cepr/vw-bus-project-ecu/hardware/tps.jpg

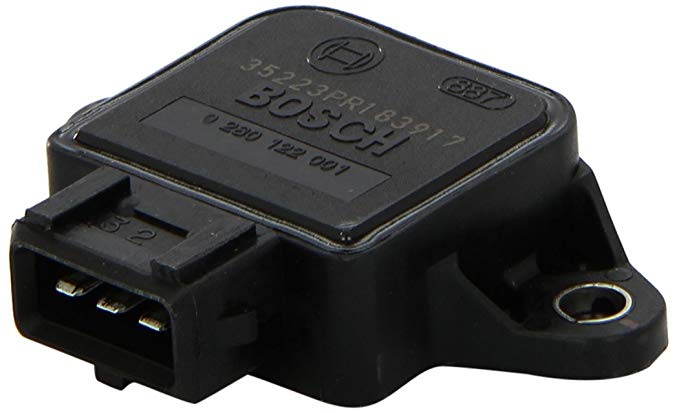
hardware/tps.jpg
