cepr/vw-bus-project-ecu/hardware/crankshaft_pos_sensor.jpg

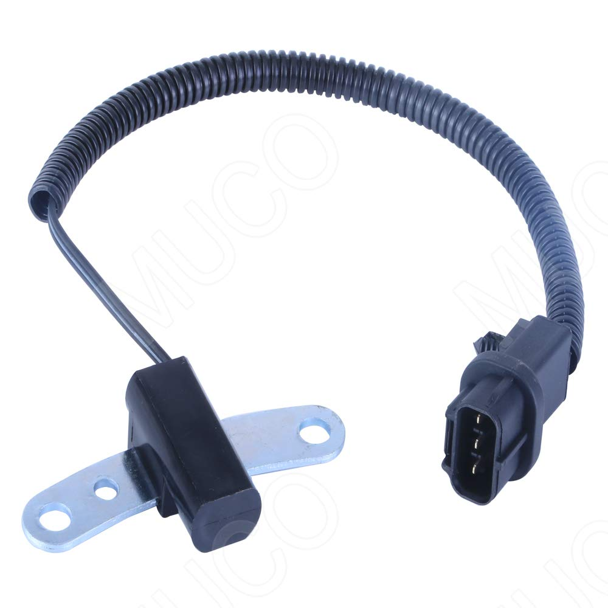
hardware/crankshaft_pos_sensor.jpg
