cepr/vw-bus-project-ecu/README.md

# vw-bus-project-ecu
ECU based on Speeduino for my VW Bus project

# Licenses
The schematics and layout are under the TAPR Open Hardware License v1.0
