cepr/vw-bus-project-ecu/hardware/ignitor.jpg

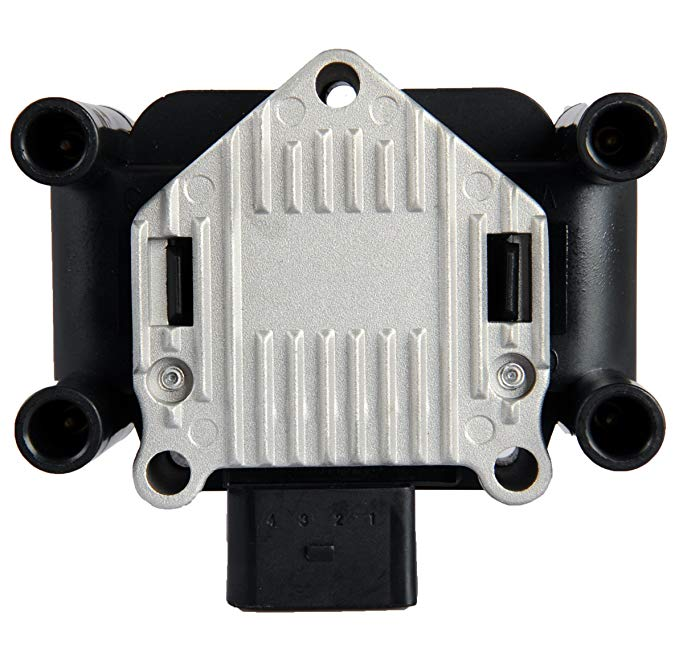
hardware/ignitor.jpg
