cepr/vw-bus-project-ecu/hardware/pdf/speeduino_mini.pdf

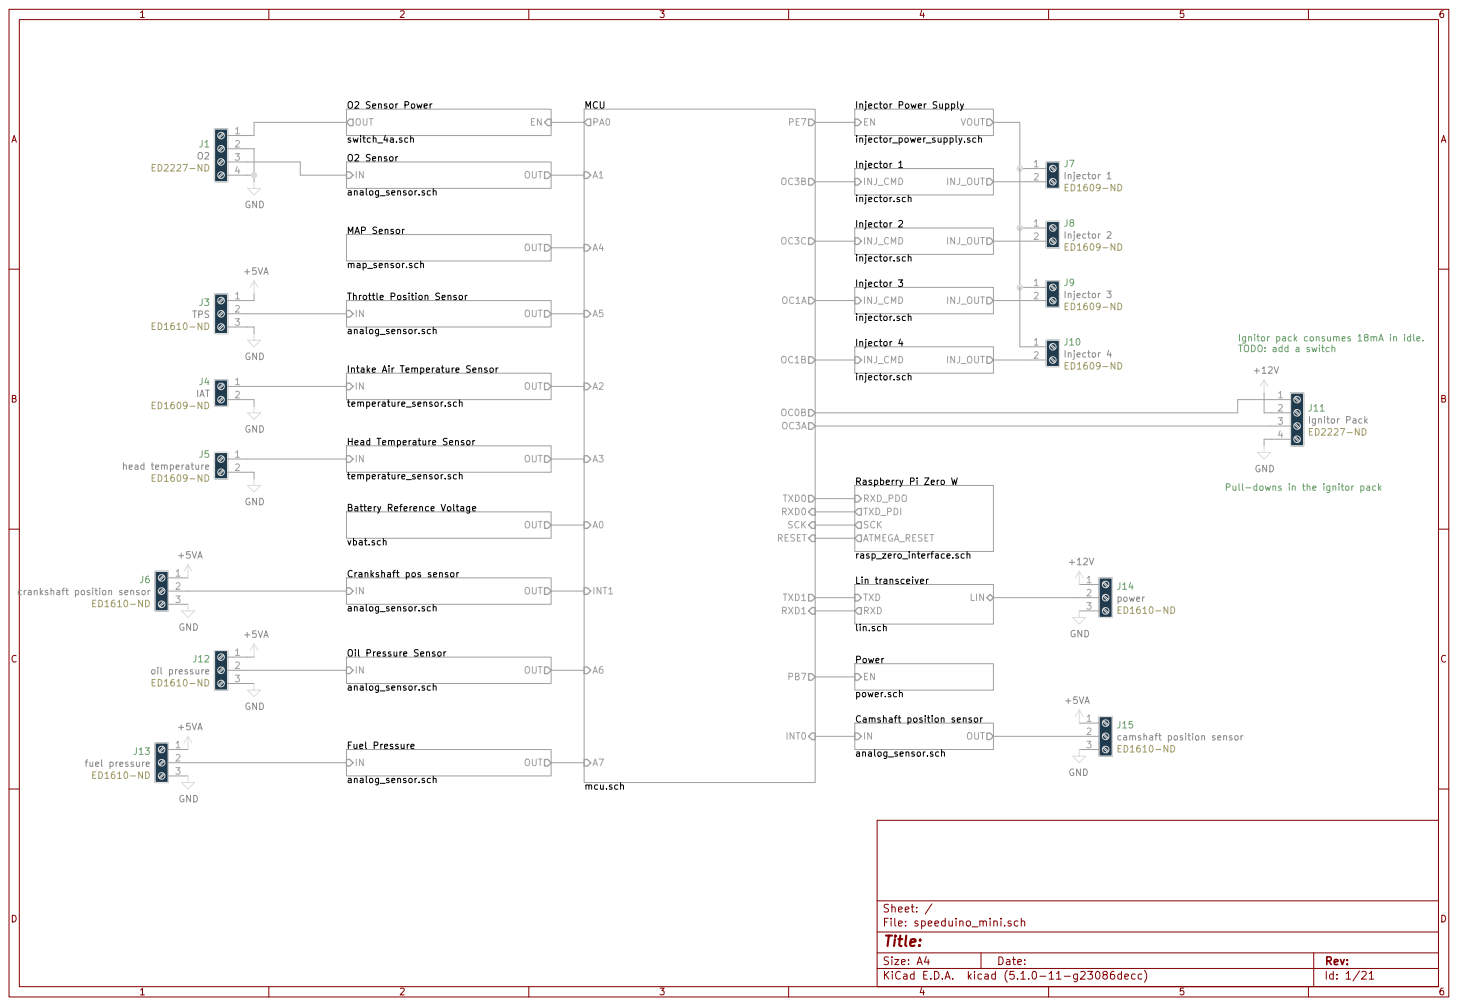
[picture p4: page 1]

Injector 3
injector.sch
Ignitor pack consumes 18mA in idle. TODO: add a switch Camshaft position sensor
Injector 4

Throttle Position Sensor analog_sensor.sch

Injector 4 ED1609-ND Oil Pressure Sensor analog_sensor.sch
Intake Air Temperature Sensor
temperature_sensor.sch

Pull-downs in the ignitor pack

crankshaft position sensor ED1610-ND

Power power.sch EN

camshaft position sensor ED1610-ND

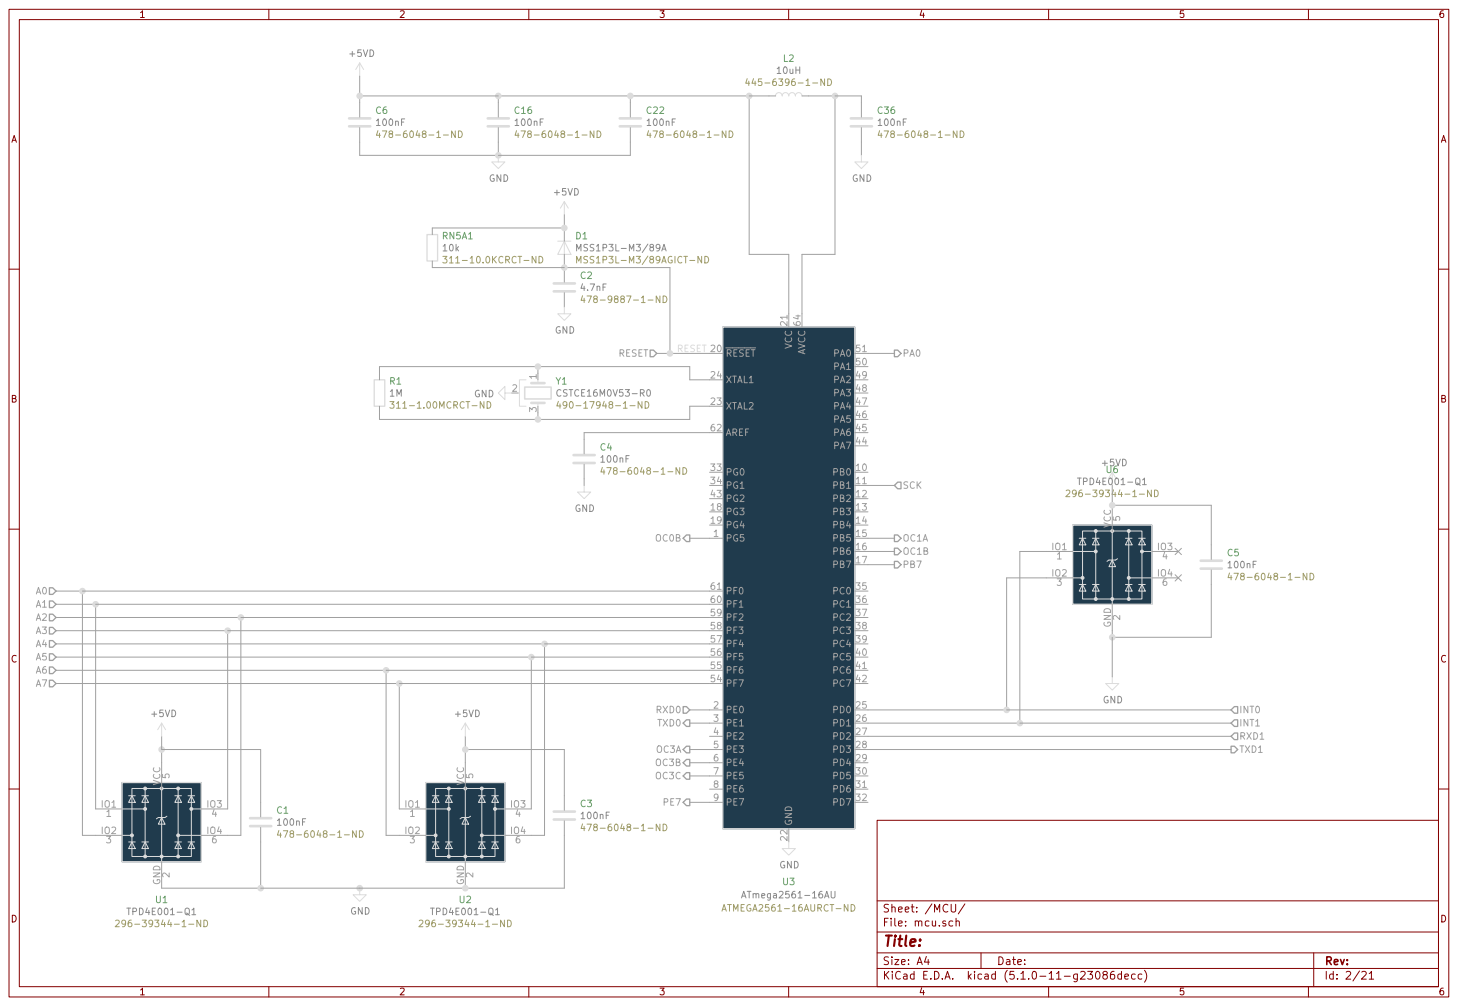
[picture p5: page 2]

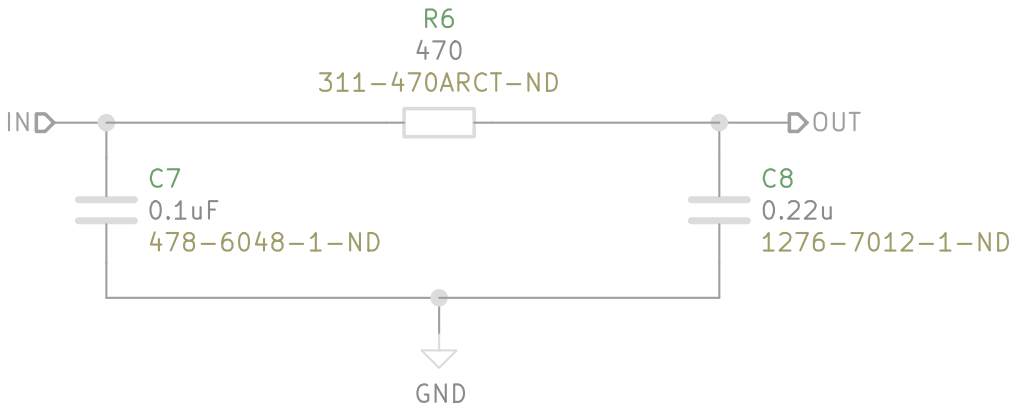
[picture p6: page 3]

File: analog_sensor.sch Sheet: /O2 Sensor/
Id: 3/21 Title:

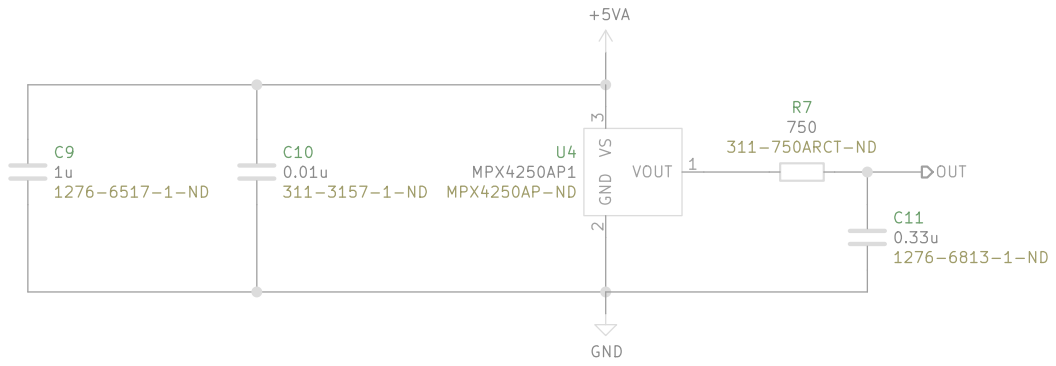
[picture p7: page 4]

File: map_sensor.sch Sheet: /MAP Sensor/
Id: 4/21 Title:

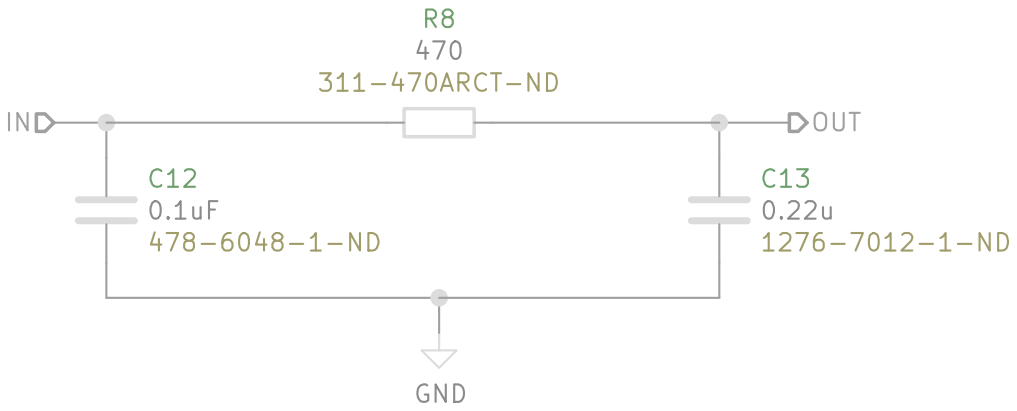
[picture p8: page 5]

File: analog_sensor.sch Sheet: /Throttle Position Sensor /
Id: 5/21 Title:

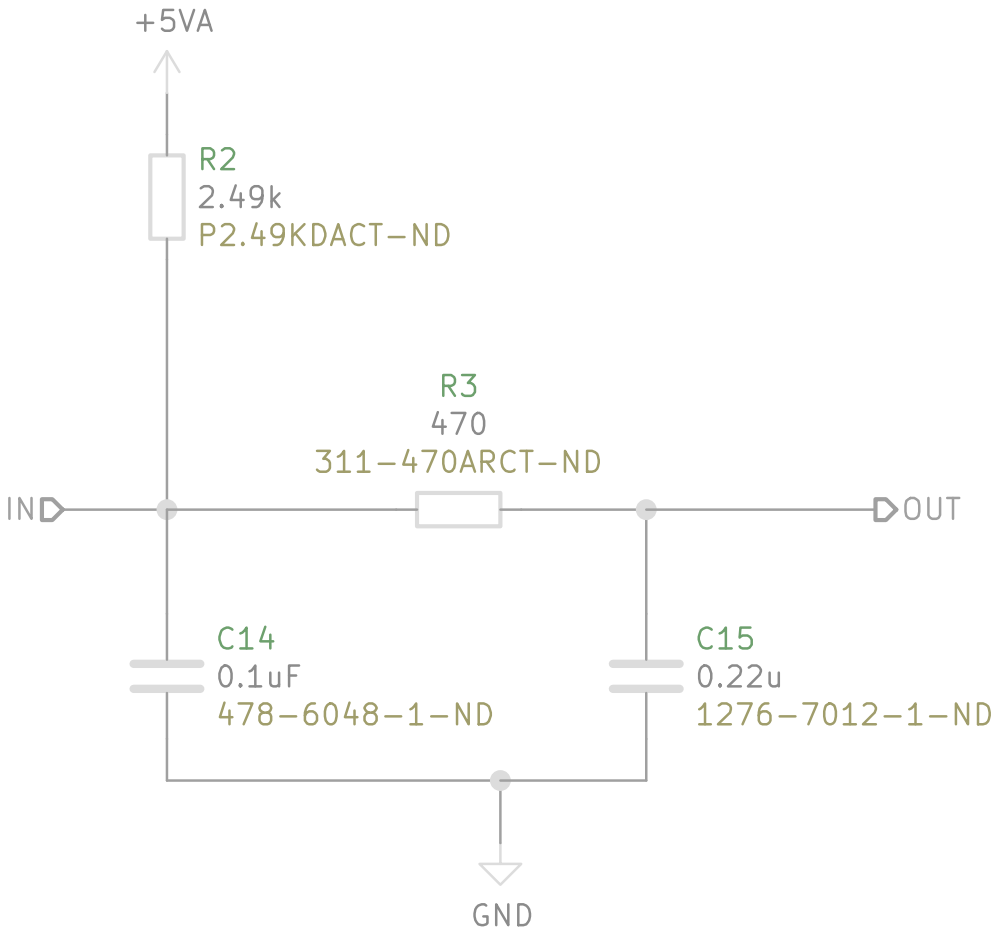
[picture p9: page 6]

Sheet: /Intake Air Temperature Sensor/
File: temperature_sensor.sch
Id: 6/21 Title:

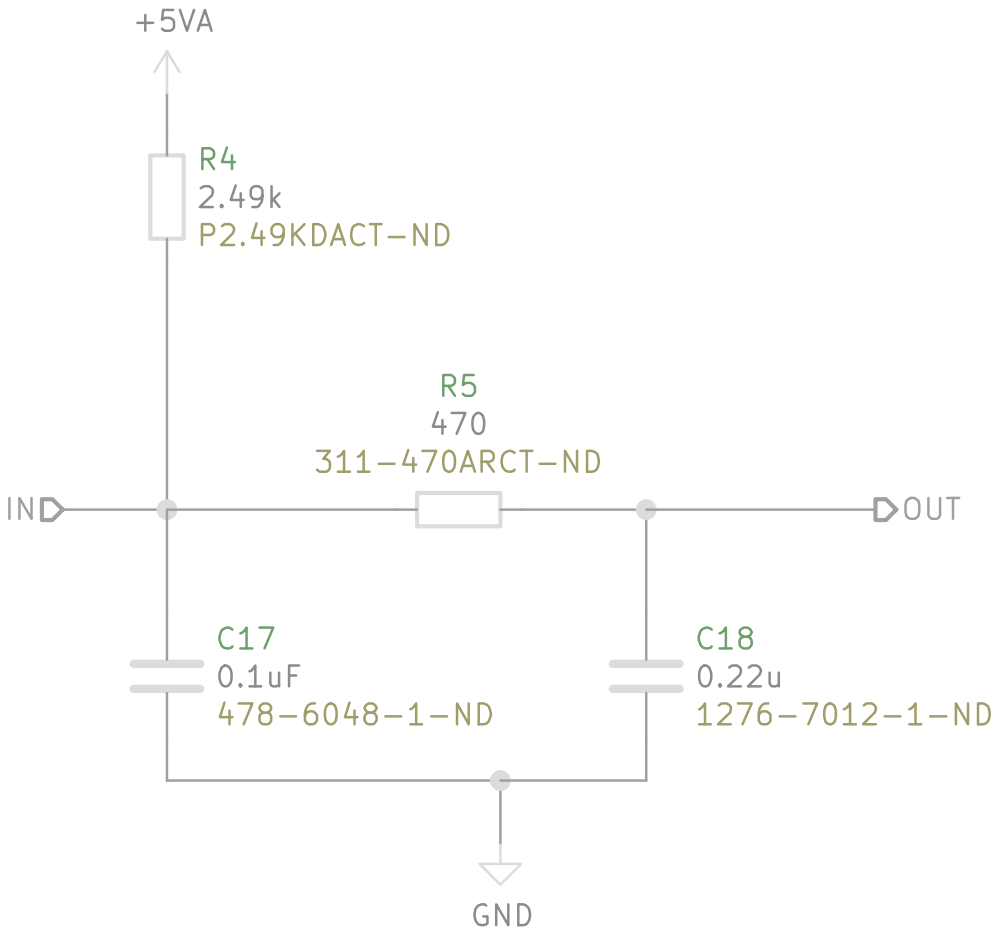
[picture p10: page 7]

Sheet: /Head Temperature Sensor/
File: temperature_sensor.sch
Id: 7/21 Title:

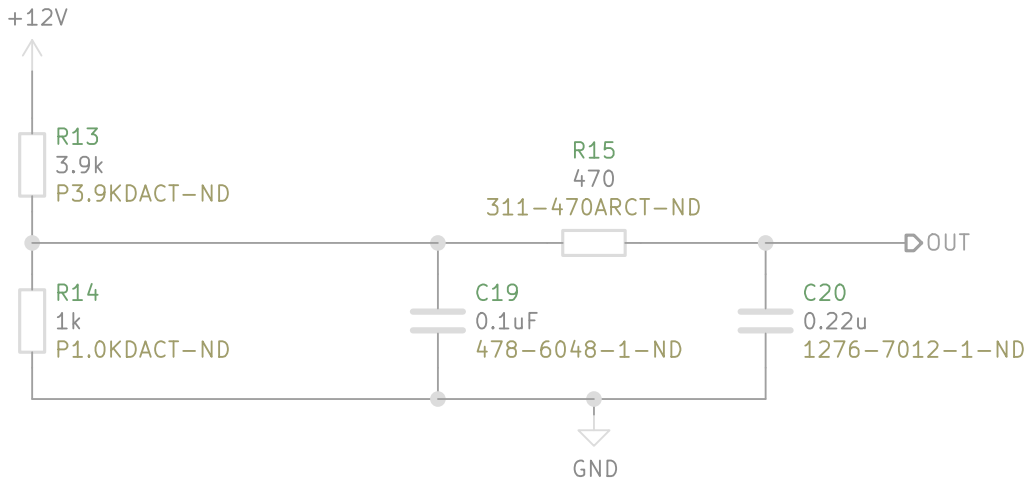
[picture p11: page 8]

Id: 8/21 Title: File: vbat.sch Sheet: /Battery Reference Voltage/

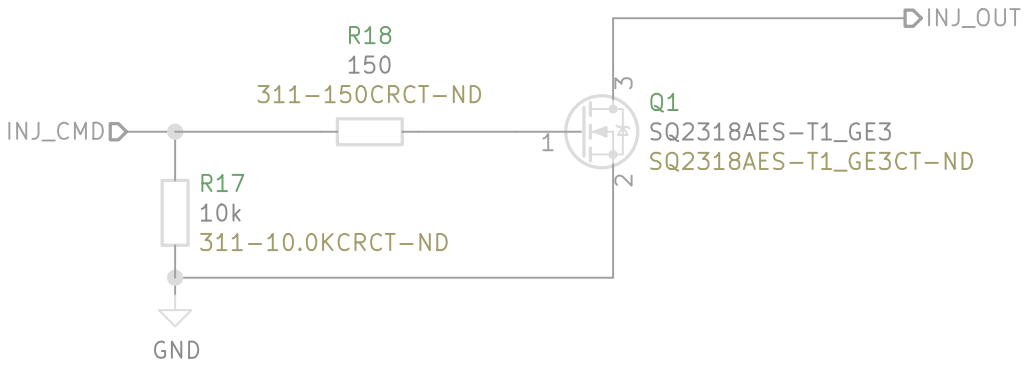
[picture p12: page 9]

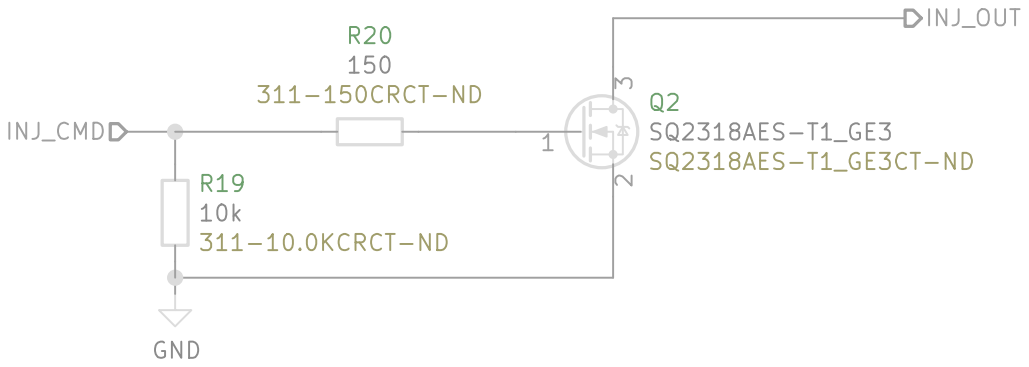
[picture p13: page 10]

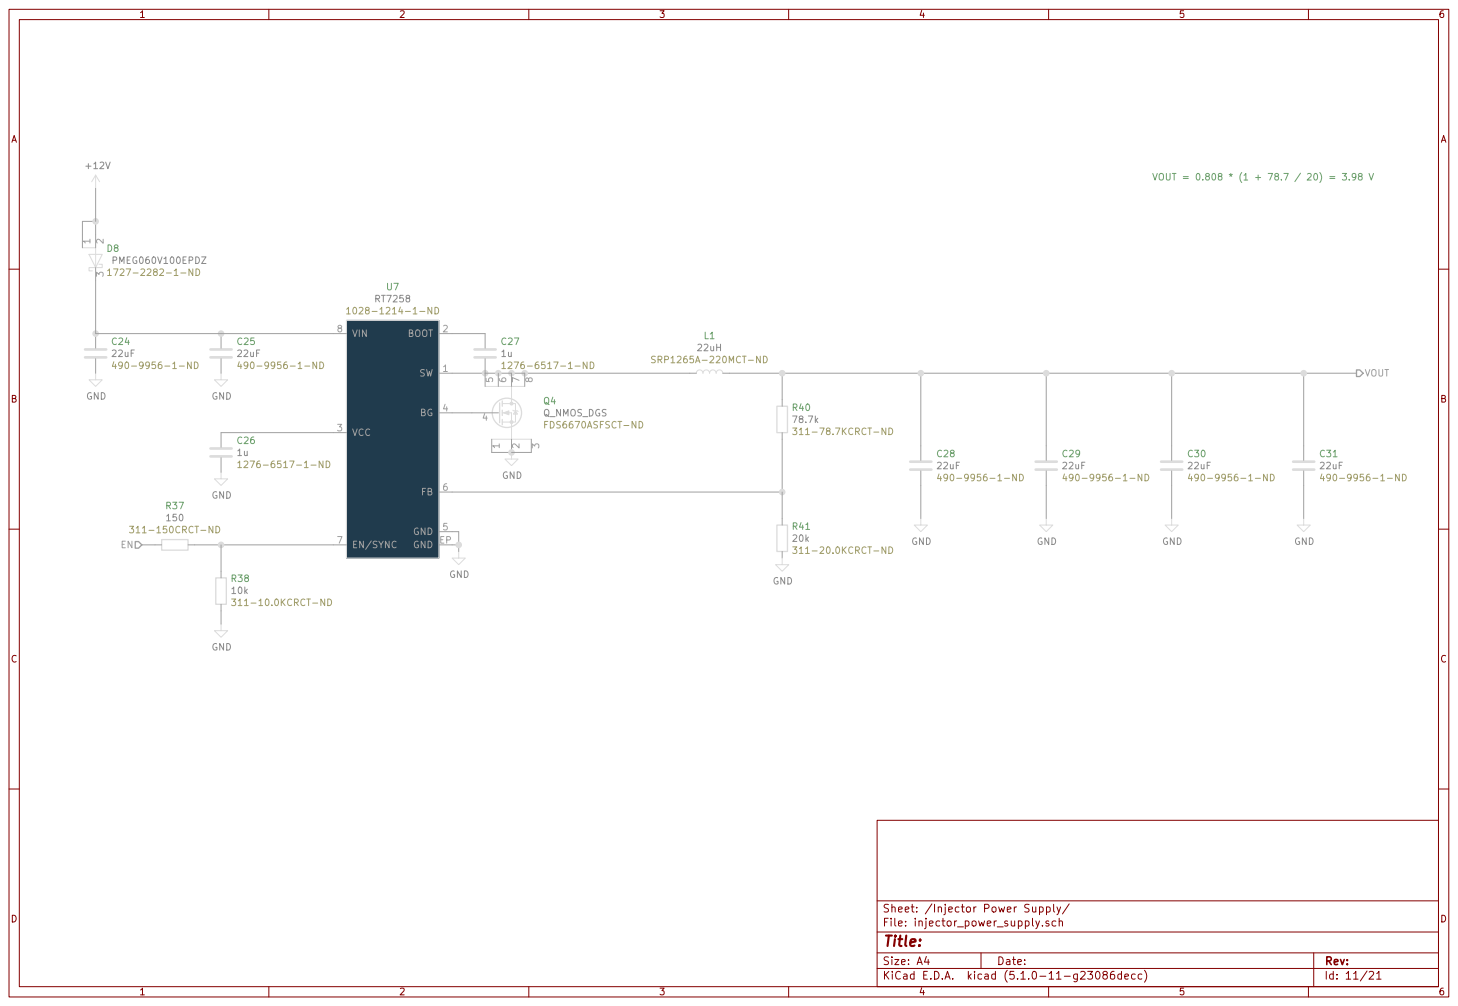
[picture p14: page 11]

Sheet: /Injector Power Supply/
File: injector_power_supply.sch
Id: 11/21 Title:

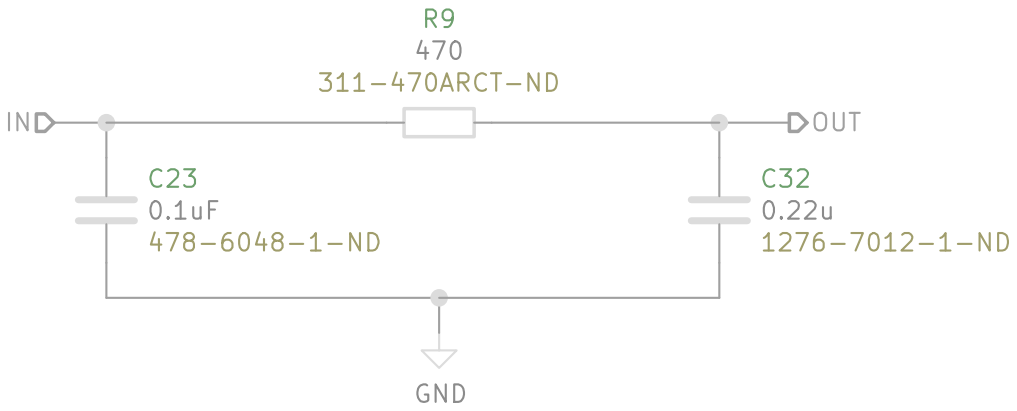
[picture p15: page 12]

File: analog_sensor.sch Sheet: /Oil Pressure Sensor/
Id: 12/21 Title:

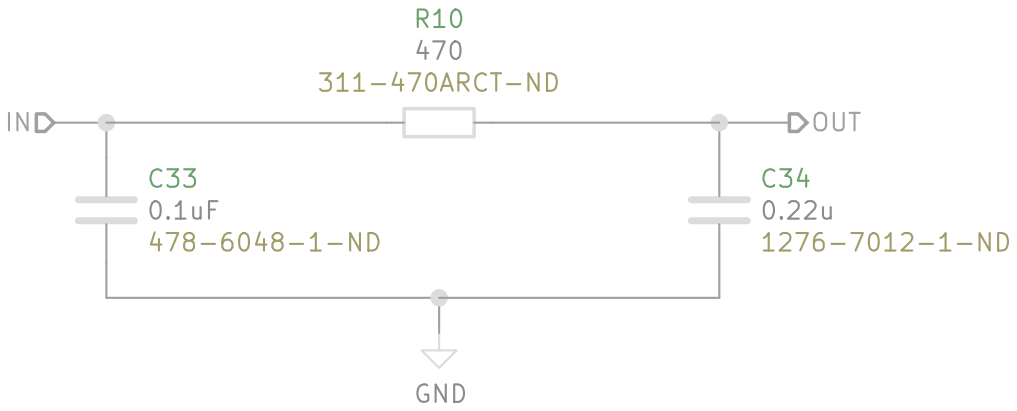
[picture p16: page 13]

File: analog_sensor.sch Sheet: /Fuel Pressure/
Id: 13/21 Title:

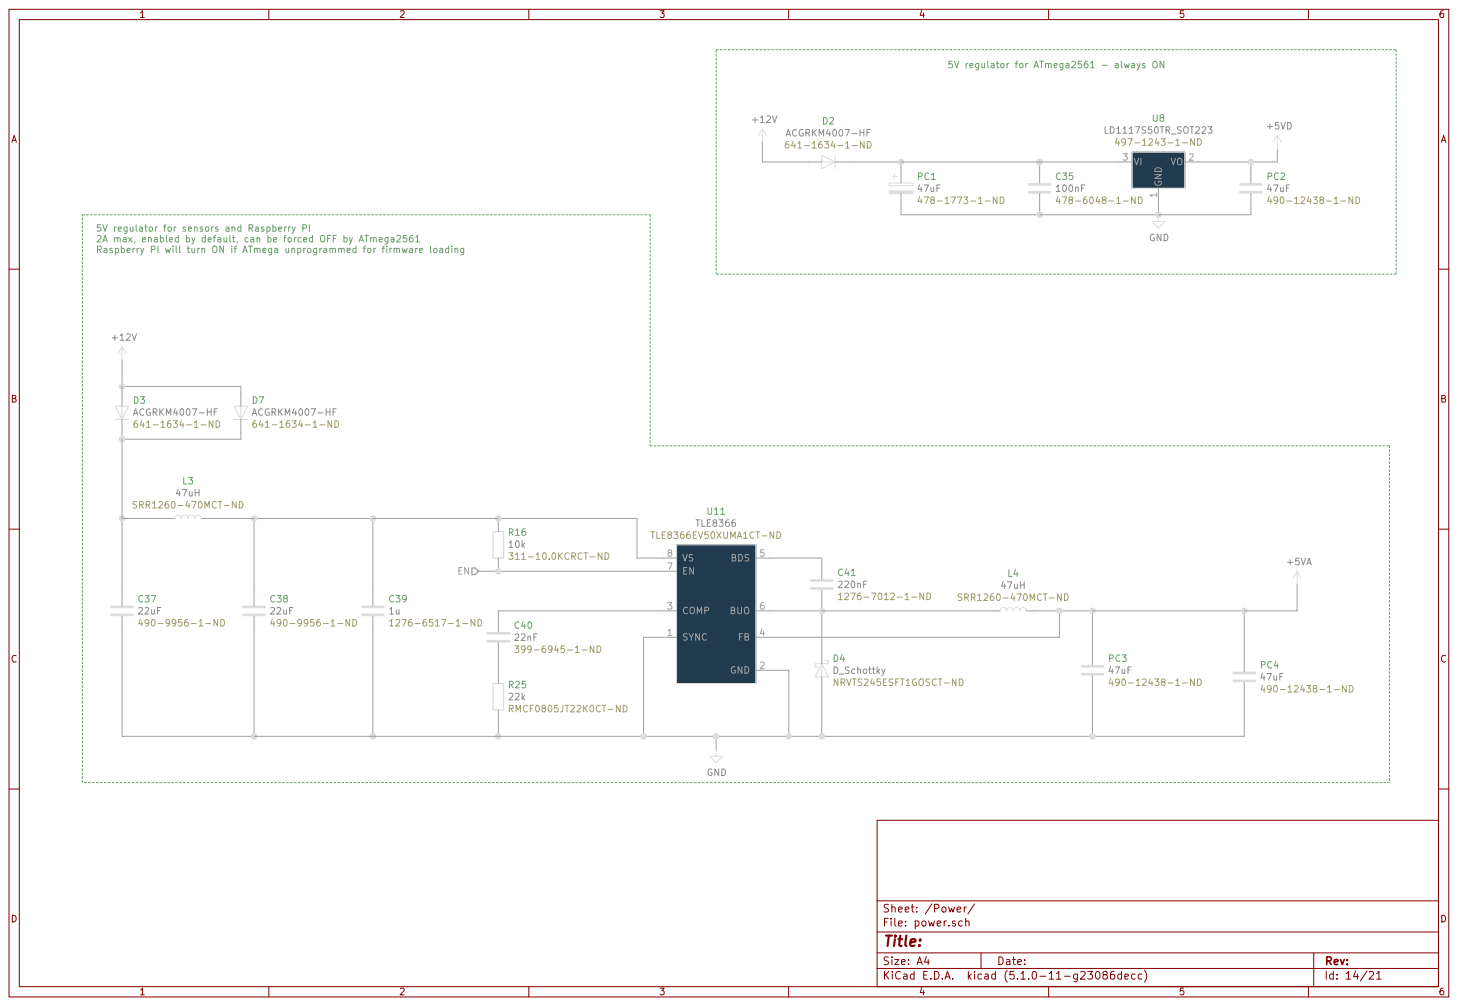
[picture p17: page 14]

5V regulator for ATmega2561 - always ON

5V regulator for sensors and Raspberry PI
2A max, enabled by default, can be forced OFF by ATmega2561

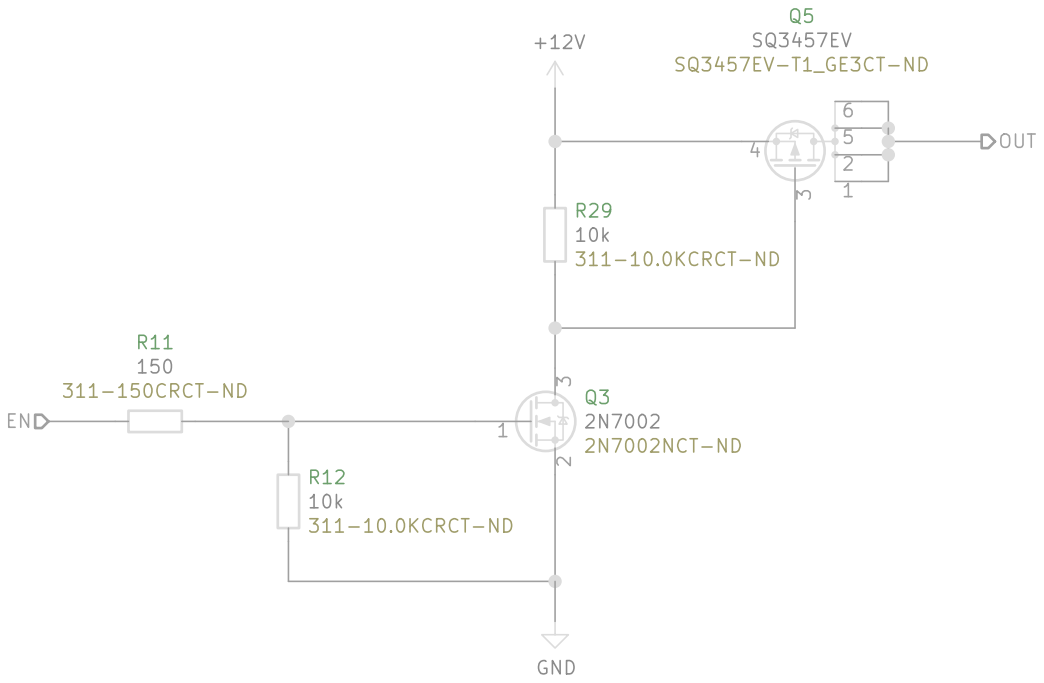
[picture p18: page 15]

File: switch_4a.sch Sheet: /O2 Sensor Power/
Id: 15/21 Title:

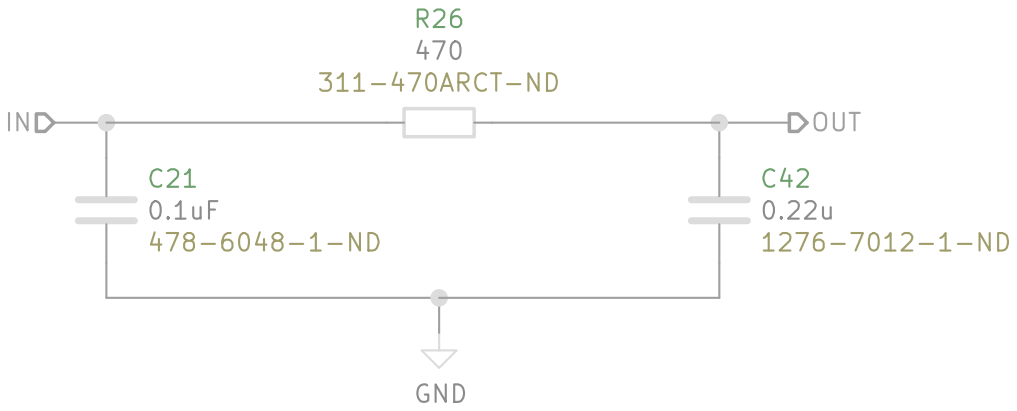
[picture p19: page 16]

Sheet: /Crankshaft pos sensor/
File: analog_sensor.sch
Id: 16/21 Title:

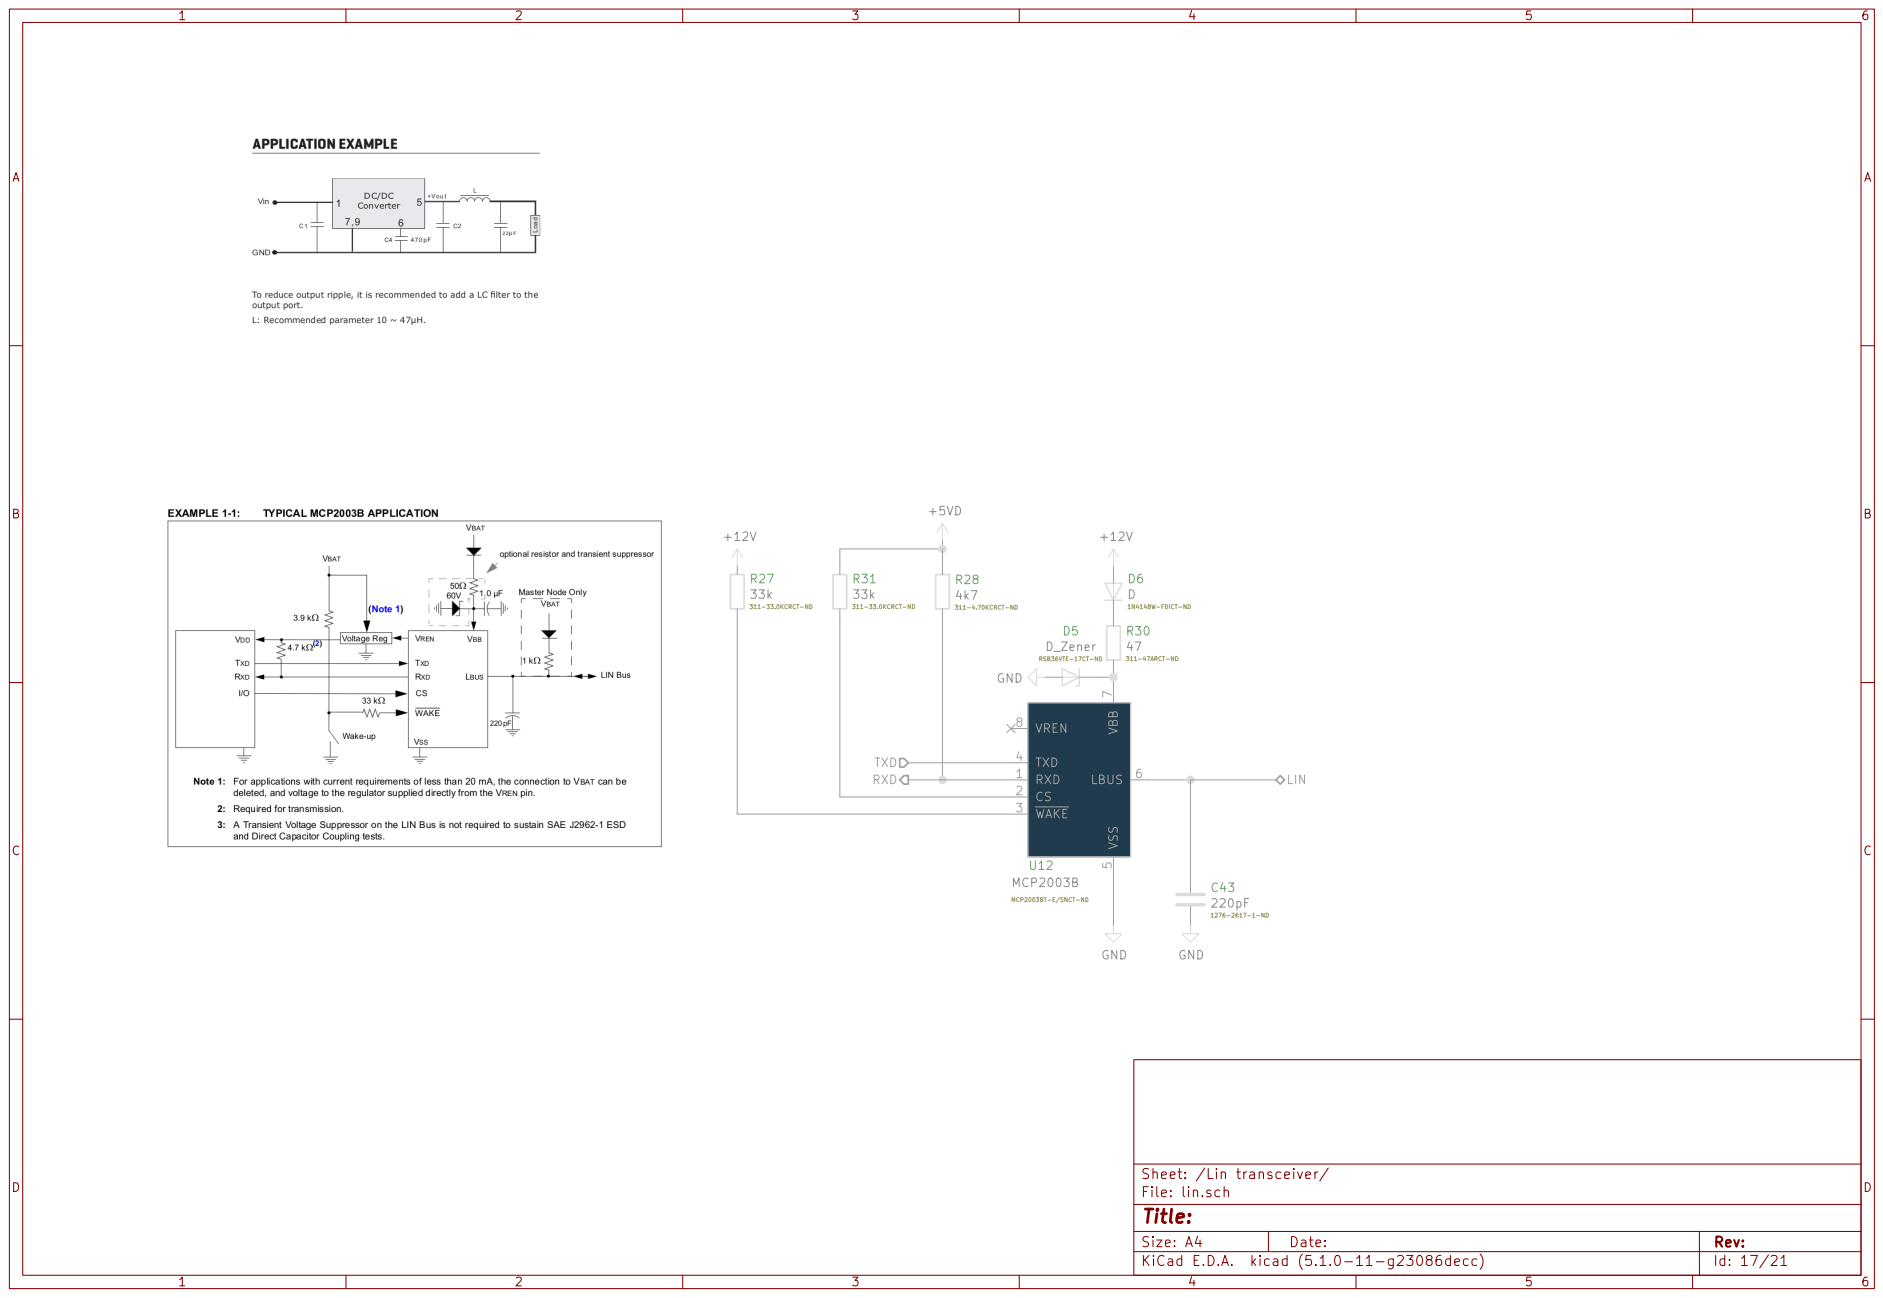
[picture p20: page 17]

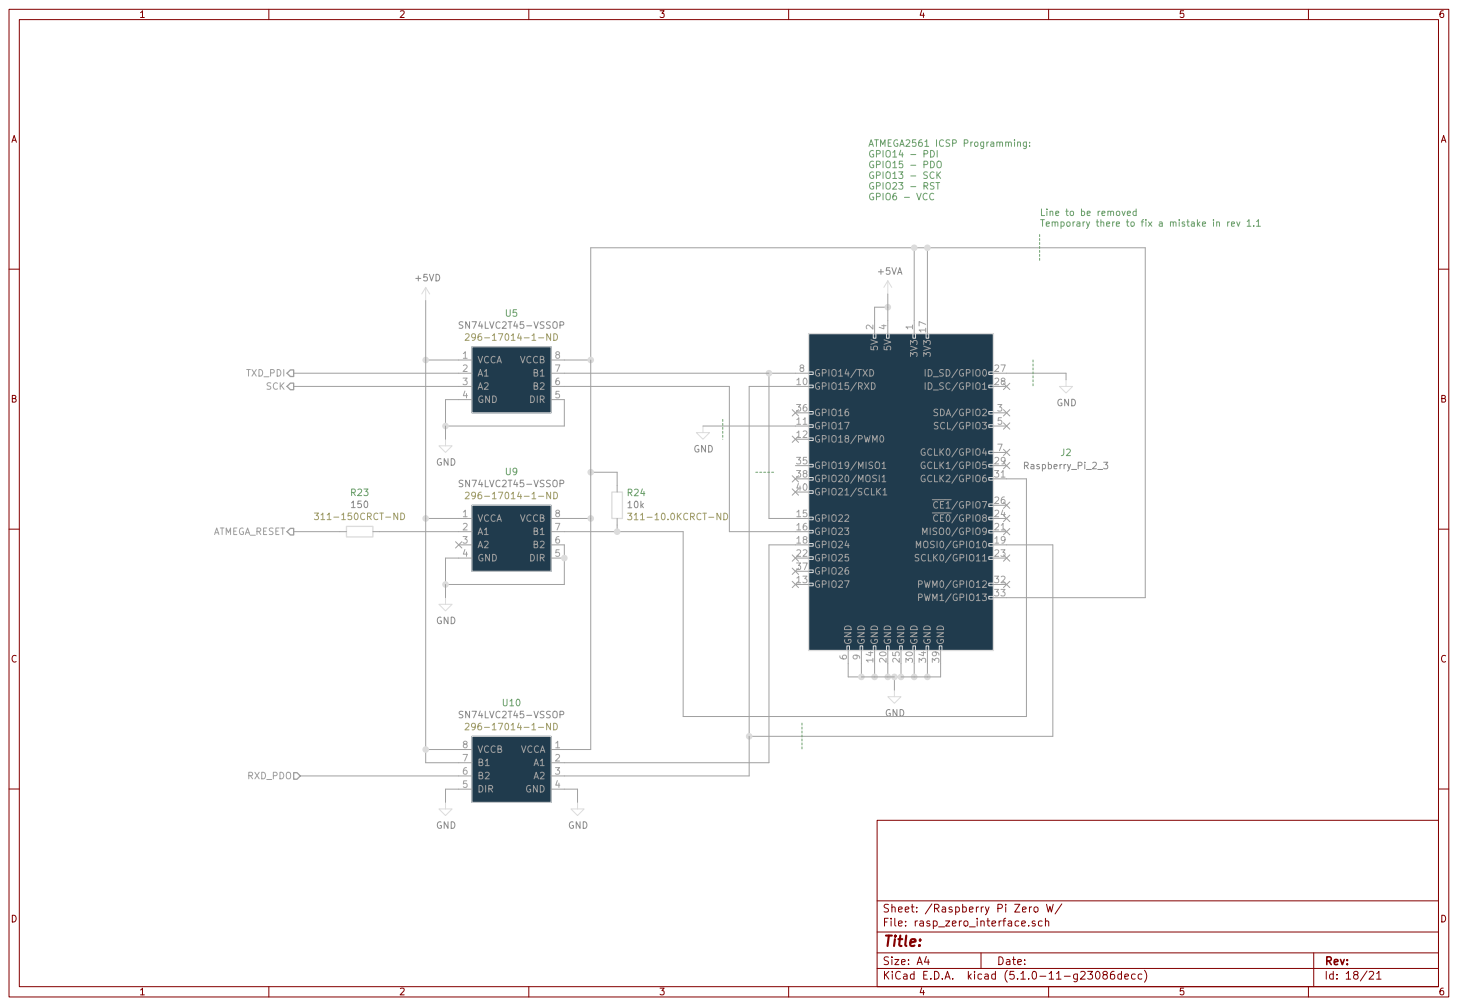
[picture p21: page 18]

ATMEGA2561 ICSP Programming: GPIO14 - PDI GPIO15 - PDO

Line to be removed Temporary there to fix a mistake in rev 1.1 GND GND

Sheet: /Raspberry Pi Zero W/ GND

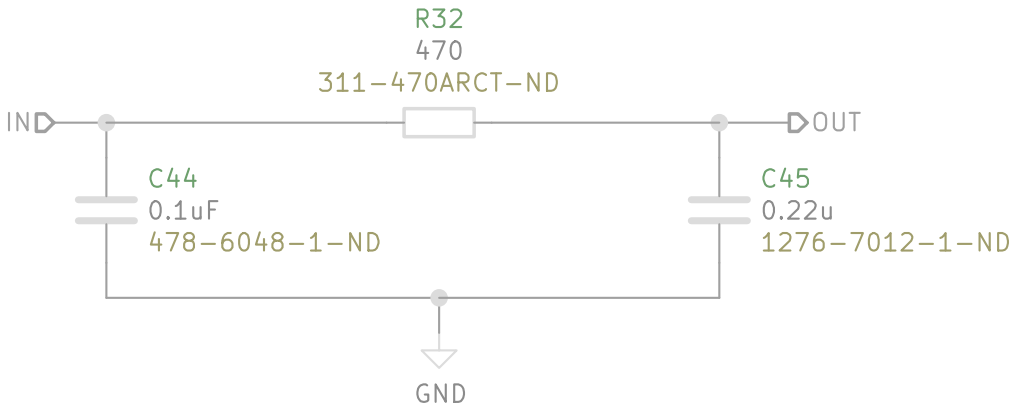
[picture p22: page 19]

Sheet: /Camshaft position sensor/
File: analog_sensor.sch
Id: 19/21 Title:

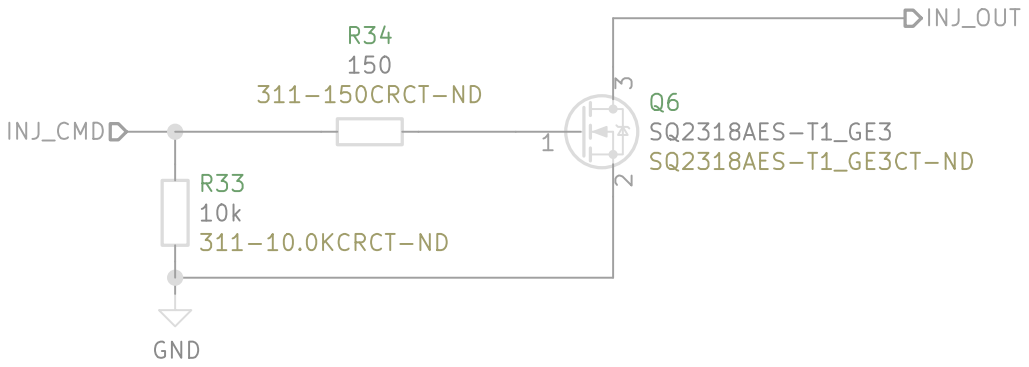
[picture p23: page 20]

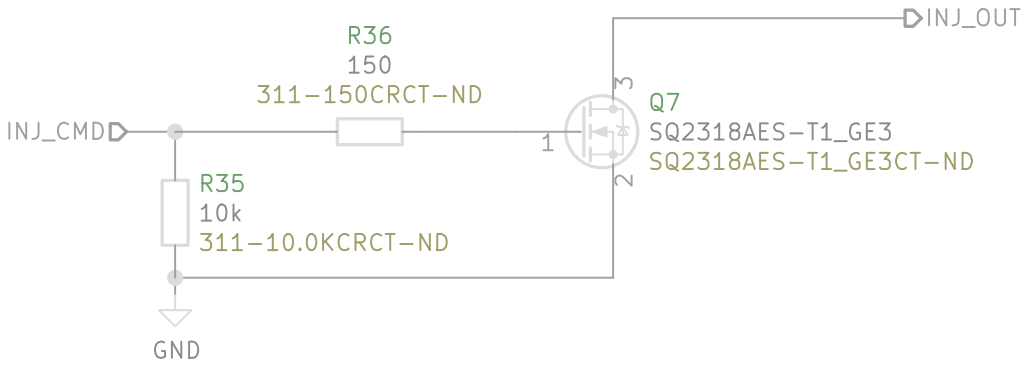
[picture p24: page 21]
