cepr/vw-bus-project-ecu/hardware/board.pdf

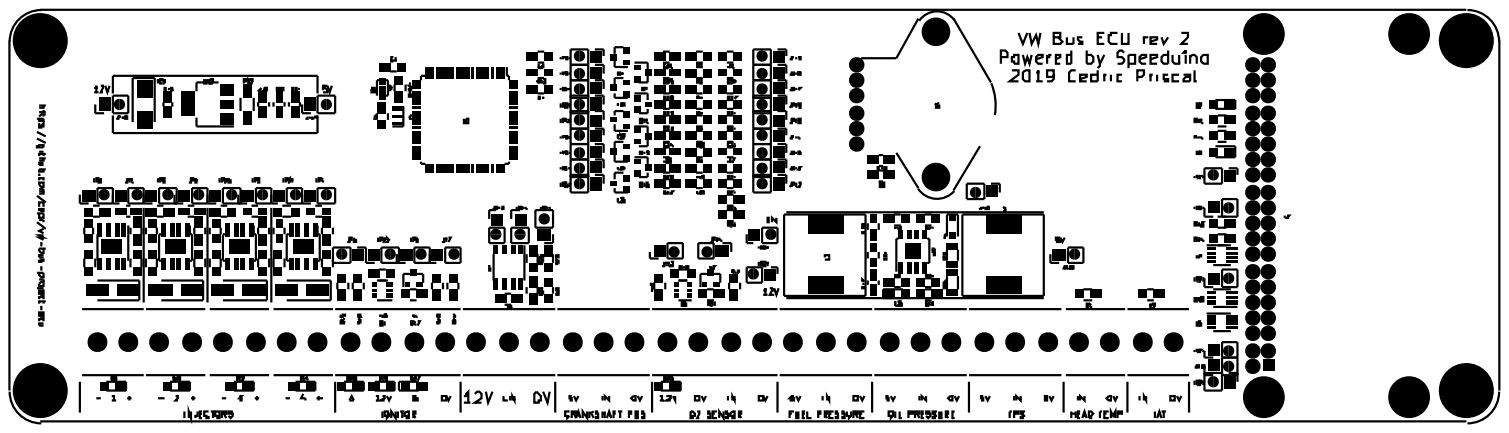
[picture p25: page 1]
