cepr/vw-bus-project-ecu/hardware/speeduino_mini.kicad_pcb

## KiCad design hardware/speeduino_mini.kicad_pcb (2019-06-16)

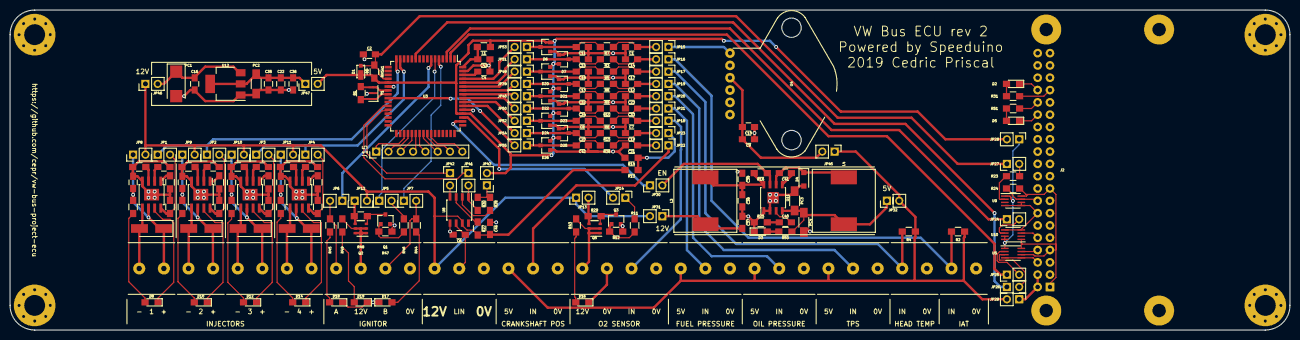
[picture p26: board speeduino_mini.kicad_pcb from above]

Board: 2 copper layers, 264.2 x 66.0 mm, 209 parts (0 on the bottom side), 147 nets.

Parts:
C1: 0.47nF 50V; C_0805_HandSoldering
C2: 4.7nF 100V; C_0805_HandSoldering
C4, C7, C12, C14, C16, C17, C19, C21, C22, C23, C33, C35, C36, C43: 0.1uF 50V; C_0805_HandSoldering
C6: 0.22nF 200V; C_0805_HandSoldering
C8, C13, C15, C18, C20, C32, C34, C41, C42: 0.22uF 50V; C_0805_HandSoldering
C9, C39, C46: 1uF 35V; C_0805_HandSoldering
C10: 10nF 100V; C_0805_HandSoldering
C11: 0.33uF 50V; C_0805_HandSoldering
C24, C26, C28, C30: 1nF 50V; C_0805_HandSoldering
C25, C27, C29, C31: 22uF 16V; C_0805_HandSoldering
C37, C38: 22uF 25V; C_0805_HandSoldering
C40: 22nF 50V; C_0805_HandSoldering
D1: MSS1P3L-M3/89A; MicroSMP
D2, D17, D18: LED BLUE 10mA 3V; LED_0805_HandSoldering
D3, D16, D19: LED GREEN 2.5mA 2.7V; LED_0805_HandSoldering
D4: D_Schottky; D_SOD-123F
D5, D8, D10, D12, D14: LED RED 10mA 1.9V; LED_0805_HandSoldering
D6, D7, D20, D21, D22, D23, D24, D25, D26: NUP1301,215; SOT-23
D9, D11, D13, D15: B340A-13-F; D_SMA_Handsoldering
H1, H2, H3, H4: MountingHole; MountingHole_4.3mm_M4_Pad_Via
J1: O2; ED120_4DS
J2: Raspberry_Pi_2_3; RaspberryPi_uHAT
J3: TPS; ED120_3DS
J4: IAT; ED120_2DS
J5: head temperature; ED120_2DS
J6: crankshaft position sensor; ED120_3DS
J7, J8, J9, J10: Injector; ED120_2DS
J11: Ignitor Pack; ED120_4DS
J12: oil pressure; ED120_3DS
J13: fuel pressure; ED120_3DS
J14: power; ED120_3DS
J15: Conn_01x08_Female; Pin_Header_Straight_1x08_Pitch2.54mm
JP1, JP2, JP3, JP4, JP5, JP6, JP7, JP8, JP9, JP10, JP11, JP12, JP13, JP14, JP15, JP16, JP17, JP18, JP19, JP20, JP21, JP22, JP23, JP24, JP25, JP26, JP27, JP28, JP29, JP30, JP31, JP32, JP39, JP40, JP41, JP42, JP43, JP45, JP46, JP47, JP49, JP50, JP51, JP52, JP53, JP54, JP55: Jumper; Pin_Header_Straight_1x02_Pitch2.54mm
L1: 10uH; L_0805_HandSoldering
L3, L4: 47uH; BOURNS_SRR1260
PC1: 47uF; CP_Tantalum_Case-C_EIA-6032-28_Reflow
PC2, PC3, PC4: 47uF 10V; C_1206_HandSoldering
Q1, Q3: 2N7002; SOT-23
Q2, Q5: SQ3457EV; TSOP-6_1.65x3.05mm_Pitch0.95mm
R1: 1M; R_0805_HandSoldering
R2, R4: 2.49k; R_0805_HandSoldering
R3, R5, R6, R8, R9, R10, R15, R26: 470; R_0805_HandSoldering
R7: 750; R_0805_HandSoldering
R11, R23, R46: 150; R_0805_HandSoldering
R12, R16, R17, R21, R24, R29, R35, R39, R47, R48: 10k; R_0805_HandSoldering
R13: 3.9k; R_0805_HandSoldering
R14, R19, R33, R37, R41: 1k; R_0805_HandSoldering
R18, R22, R36, R40: 47.5k; R_0805_HandSoldering
R20, R34, R38, R42: 26.1k; R_0805_HandSoldering
R25: 22k; R_0805_HandSoldering
R27, R28: 33k; R_0805_HandSoldering
R30: 4k7; R_0805_HandSoldering
R31, R44, R45: 200; R_0805_HandSoldering
R43, R49: 3.74k; R_0805_HandSoldering
R50: 910; R_0805_HandSoldering
R51: 309; R_0805_HandSoldering
RN5A1: 10k; R_0805_HandSoldering
U3: ATmega2561-16AU; TQFP-64_14x14mm_Pitch0.8mm
U4: MPX4250AP1; xP_01ASB0907B
U5, U9, U10: SN74LVC2T45MDCTTEP; SSOP-8_2.95x2.8mm_Pitch0.65mm
U7, U13, U14, U15: DRV103H; TI_SO-PowerPAD-8
U8: MCP2003B; SOIC-8_3.9x4.9mm_Pitch1.27mm
U11: TLE8366; SOIC-8-1EP_3.9x4.9mm_Pitch1.27mm
U12: LD1117S50TR_SOT223; SOT-223-3_TabPin2
Y1: CSTCE16M0V53-R0; Resonator_SMD_Murata-3pin_3.2x1.3mm

Connections:
+5VA: J3.1, J6.1, J12.1, J13.1, JP29.2, JP32.2, JP45.1, R2.1, R4.1
+5VD: D1.1, D6.2, D7.2, D20.2, D21.2, D22.2, D23.2, D24.2, D25.2, D26.2, JP28.2, JP43.2, JP47.2, L1.1, RN5A1.1, U3.21, U3.52
+12V: C46.1, J14.1, JP8.2, JP9.2, JP10.2, JP11.2, JP12.2, JP13.1, JP31.2, JP46.1, R13.1, R27.2, U8.7
/Crankshaft pos sensor/IN: J6.2, JP22.1
/Fuel Pressure/IN: J13.2, JP21.1
/Head Temperature Sensor/IN: J5.1, JP17.1, R4.2
/Ignitor/+12V: JP12.1, Q2.4, R48.1
/Ignitor/EN: JP5.2, R46.2
/Ignitor/IN1: J11.1, JP6.2, R45.2
/Ignitor/IN2: J11.3, JP7.2, R44.2
/Ignitor/sheet5CF8D1B3/OUT: J11.2, Q2.1, Q2.2, Q2.5, Q2.6, R49.2
/Injector 1/+12V: C25.1, D9.1, J7.1, JP8.1, R19.1, U7.6
/Injector 1/INJ_CMD: JP1.2, R17.1, U7.8
/Injector 2/+12V: C27.1, D11.1, J8.1, JP9.1, R33.1, U13.6
/Injector 2/INJ_CMD: JP2.2, R21.1, U13.8
/Injector 3/+12V: C29.1, D13.1, J9.1, JP10.1, R37.1, U14.6
/Injector 3/INJ_CMD: JP3.2, R35.1, U14.8
/Injector 4/+12V: C31.1, D15.1, J10.1, JP11.1, R41.1, U15.6
/Injector 4/INJ_CMD: JP4.2, R39.1, U15.8
/Intake Air Temperature Sensor/IN: J4.1, JP16.1, R2.2
/MAP Sensor/+5V: C9.1, C10.1, JP45.2, U4.3
/MCU/A0: C11.1, D6.3, JP53.1, R7.1
/MCU/A1: C15.1, D7.3, JP51.1, R3.1
/MCU/A2: C18.1, D20.3, JP49.1, R5.1
/MCU/A3: C13.1, D21.3, JP39.1, R8.1
/MCU/A4: C32.1, D22.3, JP40.1, R9.1
/MCU/A5: C34.1, D23.3, JP50.1, R10.1
/MCU/A6: C8.1, D24.3, JP52.1, R6.1
/MCU/A7: C20.1, D25.3, JP54.1, R15.1
/MCU/ATMEGA regulator/AVCC: C43.1, L1.2, U3.64
/MCU/INT0: C42.1, D26.3, JP55.1, R26.1
/MCU/LIN: C6.1, J14.2, U8.6
/MCU/OC1A: JP3.1, JP4.1, U3.15
/MCU/OC1B: JP1.1, JP2.1, U3.16
/MCU/OC3A: JP7.1, U3.5
/MCU/OC3B: JP5.1, U3.6
/MCU/OC3C: JP6.1, U3.7
/MCU/PA0: JP14.2, U3.51
/MCU/PA1: JP30.1, U3.50
/MCU/RESET: C2.1, D1.2, JP27.1, RN5A1.2, U3.20
/MCU/RXD0: JP25.1, U3.2
/MCU/SCK: JP26.1, U3.11
/MCU/TXD0: JP24.1, U3.3
/MCU/sheet5D16F277/+5V: JP43.1, R28.2, R30.1
/MCU/sheet5D16F277/RXD: JP41.2, R30.2, U8.1
/MCU/sheet5D16F277/TXD: JP42.2, U8.4
/O2 Sensor Power/+12V: JP13.2, Q5.4, R29.1
/O2 Sensor Power/EN: JP14.1, R11.2
/O2 Sensor Power/OUT: J1.1, Q5.1, Q5.2, Q5.5, Q5.6, R43.2
/O2 Sensor/IN: J1.3, JP18.1
/Oil Pressure Sensor/IN: J12.2, JP20.1
/Power/+5V: JP32.1, L4.2, PC3.1, PC4.1, R50.2, U11.4
/Power/+12V: C37.1, JP31.1, L3.1
/Power/EN: JP30.2, R16.1, U11.7
/Raspberry Pi Zero W/+5VA: J2.2, J2.4, JP29.1
/Raspberry Pi Zero W/+5VD: JP28.1, U5.1, U9.1, U10.7, U10.8
/Raspberry Pi Zero W/ATMEGA_RESET: JP27.2, R23.2
/Raspberry Pi Zero W/RXD_PDO: JP24.2, U10.6
/Raspberry Pi Zero W/SCK: JP26.2, U5.3
/Raspberry Pi Zero W/TXD_PDI: JP25.2, U5.2
/Throttle Position Sensor /IN: J3.2, JP19.1
GND: C1.2, C2.2, C4.2, C6.2, C7.2, C8.2, C9.2, C10.2, C11.2, C12.2, C13.2, C14.2, C15.2, C16.2, C17.2, C18.2, C19.2, C20.2, C21.2, C22.2, C23.2, C24.2, C25.2, C26.2, C27.2, C28.2, C29.2, C30.2, C31.2, C32.2, C33.2, C34.2, C35.2, C36.2, C37.2, C38.2, C39.2, C42.2, C43.2, C46.2, D2.1, D3.1, D4.2, D5.1, D6.1, D7.1, D16.1, D17.1, D18.1, D19.1, D20.1, D21.1, D22.1, D23.1, D24.1, D25.1, D26.1, J1.2, J1.4, J2.6, J2.14, J2.20, J2.30, J2.34, J3.3, J4.2, J5.2, J6.3, J11.4, J12.3, J13.3, J14.3, PC1.2, PC2.2, PC3.2, PC4.2, Q1.2, Q3.2, R12.2, R14.2, R17.2, R18.2, R20.2, R21.2, R22.2, R25.2, R34.2, R35.2, R36.2, R38.2, R39.2, R40.2, R42.2, R47.2, U3.22, U3.53, U3.63, U4.2, U5.4, U5.5, U7.4, U7.9, U8.5, U9.4, U9.5, U9.6, U10.4, U10.5, U11.1, U11.2, U11.9, U12.1, U13.4, U13.9, U14.4, U14.9, U15.4, U15.9, Y1.2
unnamed: C1.1, JP15.2, R7.2
unnamed: C4.1, U3.62
unnamed: C7.1, JP18.2, R6.2
unnamed: C12.1, JP19.2, R8.2
unnamed: C14.1, JP16.2, R3.2
unnamed: C16.1, JP46.2, PC1.1, U12.3
unnamed: C17.1, JP17.2, R5.2
unnamed: C19.1, JP23.2, R15.2
unnamed: C21.1, JP22.2, R26.2
unnamed: C22.1, C35.1, C36.1, JP47.1, PC2.1, U12.2
unnamed: C23.1, JP20.2, R9.2
unnamed: C24.1, U7.2
unnamed: C26.1, U13.2
unnamed: C28.1, U14.2
unnamed: C30.1, U15.2
unnamed: C33.1, JP21.2, R10.2
unnamed: C38.1, C39.1, L3.2, R16.2, U11.8
unnamed: C40.1, U11.3
unnamed: C40.2, R25.1
unnamed: C41.1, U11.5
unnamed: C41.2, D4.1, L4.1, U11.6
unnamed: D2.2, R31.1
unnamed: D3.2, R50.1
unnamed: D5.2, R51.1
unnamed: D8.1, U7.7
unnamed: D8.2, R19.2
unnamed: D9.2, J7.2, U7.5
unnamed: D10.1, U13.7
unnamed: D10.2, R33.2
unnamed: D11.2, J8.2, U13.5
unnamed: D12.1, U14.7
unnamed: D12.2, R37.2
unnamed: D13.2, J9.2, U14.5
unnamed: D14.1, U15.7
unnamed: D14.2, R41.2
unnamed: D15.2, J10.2, U15.5
unnamed: D16.2, R43.1
unnamed: D17.2, R44.1
unnamed: D18.2, R45.1
unnamed: D19.2, R49.1
unnamed: J2.1, J2.17, R24.2, U5.8, U9.8, U10.1
unnamed: J2.7, U5.6
unnamed: J2.8, U5.7
unnamed: J2.10, U10.3
unnamed: J2.16, R24.1, U9.7
unnamed: J2.32, R51.2
unnamed: J2.33, R31.2
unnamed: J15.1, U3.35
unnamed: J15.2, U3.36
unnamed: J15.3, U3.37
unnamed: J15.4, U3.38
unnamed: J15.5, U3.39
unnamed: J15.6, U3.40
unnamed: J15.7, U3.41
unnamed: J15.8, U3.42
unnamed: JP15.1, U4.1
unnamed: JP23.1, R13.2, R14.1
unnamed: JP39.2, U3.58
unnamed: JP40.2, U3.57
unnamed: JP41.1, U3.27
unnamed: JP42.1, U3.28
unnamed: JP49.2, U3.59
unnamed: JP50.2, U3.56
unnamed: JP51.2, U3.60
unnamed: JP52.2, U3.55
unnamed: JP53.2, U3.61
unnamed: JP54.2, U3.54
unnamed: JP55.2, U3.25
unnamed: Q1.1, R46.1, R47.1
unnamed: Q1.3, Q2.3, R48.2
unnamed: Q3.1, R11.1, R12.1
unnamed: Q3.3, Q5.3, R29.2
unnamed: R1.1, U3.24, Y1.1
unnamed: R1.2, U3.23, Y1.3
unnamed: R18.1, U7.3
unnamed: R20.1, U7.1
unnamed: R22.1, U13.3
unnamed: R23.1, U9.2
unnamed: R27.1, U8.3
unnamed: R28.1, U8.2
unnamed: R34.1, U13.1
unnamed: R36.1, U14.3
unnamed: R38.1, U14.1
unnamed: R40.1, U15.3
unnamed: R42.1, U15.1
