cepr/vw-bus-project-ecu/(commit log)

2019-02-18 Work in progress
    [analog_sensor.sch, ignitor.sch, injector.sch, injector_power_supply.sch, map_sensor.sch, mcu.sch, power.sch, rasp_zero_interface.sch]
2019-02-26 work in progress - components ordered
    [analog_sensor.sch, injector.sch, injector_power_supply.sch, lin.sch, mcu.sch, power.sch, rasp_zero_interface.sch, speeduino_mini.kicad_pcb]
2019-03-17 rev 1
    [analog_sensor.sch, injector.sch, injector_power_supply.sch, lin.sch, map_sensor.sch, mcu.sch, power.sch, rasp_zero_interface.sch]
2019-04-10 rev 1.1
    [injector.sch, injector_power_supply.sch, speeduino_mini.kicad_pcb, temperature_sensor.sch]
2019-04-18 Adding corrections for wrong raspberry pi pinout
    [rasp_zero_interface.sch, speeduino_mini.kicad_pcb, temperature_sensor.sch]
2019-05-19 Rev 2 work in progress
    [analog_sensor.sch, atmega_regulator.sch, ignitor.sch, injector.sch, injector_power_supply.sch, lin.sch, map_sensor.sch, mcu.sch]
2019-05-21 hardware rev2 - layout complete
    [analog_sensor.sch, map_sensor.sch, mcu.sch, rasp_zero_interface.sch, speeduino_mini.kicad_pcb, speeduino_mini.sch, temperature_sensor.sch, vbat.sch]
2019-05-30 rev 2 sent to fab
    [analog_sensor.sch, atmega_regulator.sch, digikey.csv, ignitor.sch, injector.sch, lin.sch, map_sensor.sch, mcu.sch]
2019-06-16 Moved PC3, fixed R25, D3, C40 and R50 silkscreen
    [speeduino_mini.kicad_pcb]
2020-10-24 old commit from v1
    [analog_sensor.sch, atmega_regulator.sch, ignitor.sch, injector.sch, lin.sch, map_sensor.sch, mcu.sch, power.sch]
